hmaerki/experiment_microoctopus/README.md

# HIL (Hardware in the Loop) testinfrastructure

**This repo has to be moved to https://github.com/octoprobe**
