hmaerki/experiment_microoctopus/assessments/assessment_docker_and_udev/README.md

* https://medium.com/swlh/hot-plugging-usb-devices-in-balenaos-5dca4b05ca7e
* https://forums.docker.com/t/udevadm-monitor-in-docker-file/125723
* https://github.com/systemd/systemd/blob/main/rules.d/60-serial.rules
* https://forums.balena.io/t/libudev-cannot-monitor-udev-events-inside-container/363638
