hmaerki/experiment_microoctopus/assessments/assessment_pyudev/README.md

* https://forum.micropython.org/viewtopic.php?t=6063

  * Dave Hylands
    * https://github.com/dhylands/dotfiles/blob/master/bin/find_port.py
    * https://github.com/dhylands/usb-ser-mon.git
    
      * https://github.com/dhylands/usb-ser-mon/blob/master/usb_ser_mon/usb_ser_mon.py

```bash
pip install git+https://github.com/dhylands/usb-ser-mon.git
```

==> Could not make working...

```bash
git clone https://github.com/kjcole/usb-ser-mon
python usb-ser-mon/usb-ser-mon.py -l
USB Serial Device with vendor 'MicroPython' serial '4150325537323318' found @/dev/ttyACM0
USB Serial Device with vendor 'MicroPython' serial 'e661640843495f21' found @/dev/ttyACM1
```

# pyudev

* https://github.com/pyudev
* https://pyudev.readthedocs.io/en/latest/
