hmaerki/experiment_microoctopus/design/design_system.md

# Components

## octoprobe.infa

## octoprobe.infra.usbhub

* Receive USB events
* Know hubs

## octoprobe.tentacle

* Knows RP20240 on the tentacle
* Flash RP2040 (power, picotool, get serial & /dev/usb)
* Given /dev/xy from the tentacle-rp2040
  * Switch relays

## octoprobe.reservation

* Allocations base on tags
