hmaerki/experiment_microoctopus/design/reed_relais.md

https://www.aliexpress.com/item/32788773655.html

https://www.aliexpress.com/item/1005004818274573.html

https://www.aliexpress.com/item/1005003234064658.html

https://www.aliexpress.com/item/1005003025355512.html

https://www.aliexpress.com/item/1005006040700348.html

https://www.aliexpress.com/item/1005004822301240.html

https://jlcpcb.com/partdetail/PanChang-SIP1A05/C10496
  USD 0.68

https://jlcpcb.com/partdetail/CosmoElectronics-D1A050000/C150533
  USD 0.74

Photocouplers
https://jlcpcb.com/partdetail/Toshiba-TLP172GM_TPL_EO/C261926
file:///home/hansm/Downloads/TLP172GM(TPL,E(O.pdf

22 Ohm, COff 30pF

file:///home/hansm/Downloads/TLP172AM(TPL,E.pdf
1 Ohm

Power: FET
IO: photo-MOSFET
