hmaerki/experiment_microoctopus/design/collected_shields.md

# Existing shields

## Raspberry Pi Pico

* Negative: Does not support ribbon cable
* Positive: Stackable Design
* 2x 20 pin

Examples

* https://www.waveshare.com/pico-lora-sx1262-868m.htm
* https://www.waveshare.com/pico-esp8266.htm
* https://www.waveshare.com/pico-10dof-imu.htm
* https://www.waveshare.com/pico-ups-b.htm
* https://www.waveshare.com/pico-environment-sensor.htm
* https://www.waveshare.com/pico-ble.htm
* https://www.waveshare.com/product/pico-ups-a.htm
* https://thepihut.com/products/pico-air-monitoring-expansion

## Raspberry Pi

* 2x20pin

Implemented by

* https://www.play-zone.ch/de/stacking-header-for-raspberry-pi-b-2x20-extra-tall-header-2734.html / https://www.play-zone.ch/de/fileuploader/download/download/?d=1&file=custom%2Fupload%2FFile-1492015621.pdf
* https://www.reichelt.com/ch/de/raspberry-pi-shield-dip-europakarte-stapelbar-rpi-shd-euro-fr4-p243854.html

 * 100 x 160 mm
 * https://cdn-reichelt.de/documents/datenblatt/A300/INFO_RE3020-LF.pdf
 * https://cdn-reichelt.de/documents/datenblatt/A300/EN_RE3020-LF.pdf

Pi stack

* https://www.waveshare.com/stack-hat.htm
  * [Schematic](https://files.waveshare.com/upload/a/ad/Stack_HAT_Schematic.pdf)

Pico vs Pi

* [Pico vs Pi](https://thepihut.com/products/hat-breakout-board-for-raspberry-pi-pico)
  * https://github.com/geeekpi/rpico
  * https://wiki.52pi.com/index.php?title=EP-0139
  * ? schematic not found!

* [Pico vs Pi](https://ch.rs-online.com/web/p/raspberry-pi-hats-und-add-ons/2240176)
  * https://docs.rs-online.com/eddb/A700000007867654.pdf
  * https://www.pi-shop.ch/raspberry-pi-pico-hat-expansion
  * schematic available!

* [Pico vs Pi](https://www.waveshare.com/pico-to-hat.htm)
  * ? schematic not found!

Components

* [Extra Tall Header Kit](https://thepihut.com/products/poe-hat-push-fit-extra-tall-header-kit)
* https://www.pi-shop.ch/geeekpi-40pin-header-kit-box
* https://www.dfrobot.com/product-2358.html
* https://thepihut.com/products/hat-ribbon-cable-for-raspberry-pi-400
* https://thepihut.com/products/pinpal-for-pi-400
* https://thepihut.com/products/40-pin-gpio-ribbon-cable-rainbow-150mm
* https://thepihut.com/products/26-pin-gpio-ribbon-cable-grey-150mm
* https://thepihut.com/products/gpio-ribbon-cable-for-raspberry-pi-model-a-b-pi-2-pi-3
* https://thepihut.com/products/40-pin-extra-tall-header-push-fit-version-no-shroud
* https://thepihut.com/products/breakout-plus
* https://thepihut.com/products/phat-stack
* https://thepihut.com/products/gravity-io-expansion-hat-for-raspberry-pi-4
* https://thepihut.com/products/io-expansion-hat-for-raspberry-pi-3-4-400
* https://thepihut.com/products/giant-butterfly-for-raspberry-pi

Examples

* https://thepihut.com/products/16-universal-inputs-8-layer-stackable-card-for-raspberry-pi
* https://thepihut.com/products/three-40a-240v-relays-rs485-daisy-chainable-hat-for-raspberry-pi
* https://thepihut.com/products/air-monitoring-hat-for-raspberry-pi-pmsa003
* https://thepihut.com/products/gpio-reference-board-model-b-plus-and-a-plus
* https://thepihut.com/products/iqaudio-dac-pro
* https://thepihut.com/products/fan-shim-for-raspberry-pi

# Kicad Pi Hats

* https://github.com/raspberrypi/hats

* https://github.com/devbisme/RPi_Hat_Template
* https://github.com/devbisme/RPi_Hat.pretty
