hmaerki/experiment_microoctopus/design/collected.md

# Espressif

https://github.com/espressif/kicad-libraries

# Raspberry Pico

The Pico minimal design example project has KiCAD symbols/footprints for the RP2040 itself: https://datasheets.raspberrypi.com/rp20 ... -KiCAD.zip

The VGA project has KiCAD symbols/footprints for soldering in a Pico itself:
https://datasheets.raspberrypi.com/rp2040/VGA-KiCAD.zip

https://github.com/ncarandini/KiCad-RP-Pico

# Seeed Pico

https://www.seeedstudio.com/blog/2022/08/19/how-to-use-seeed-studio-xiao-in-your-pcb-design/

https://github.com/Seeed-Studio/OPL_Kicad_Library

# Raspberry Pi

https://github.com/HeadBoffin/RP_Silicon_KiCad
