hmaerki/experiment_microoctopus/design/concept.md

# Gadgets

## Home made gadgets

## Groove Gadgets

## Pico Header Gadgets

# Buses

## Controller Bus

### Control

* I2C
* Power for controller rp2040

Every board has its jumpered unique I2C address.

The controller ochestrates the test using the Control Bus

### Power

Switchable Power. 3V3 and 5V.

### USB

## Gadget Bus

### Power

Switchable Power. 3V3 and 5V.

### IO

* 16x IO
