hmaerki/experiment_microoctopus/branding/octoprobe/octoprobe_logo_v3_inkscape.md

# Create a logo with inkscape

## Rectangle with rounded corners

https://youtu.be/JXrzemHHQG0?si=g5I7pK4Sno1xLvji

## Font

Inkscape: `Manjari`, `Bold`, Font size `18`

## Add a black rectangle and place the text `probe`

Click `probe`, then the rectangle. Menu `Path -> Difference`.

Now the black rectangle has the text `probe` cut out.

## Place text `Octo` and `tentacles`

As Kicad import will ignore the font, the text must be converted into a path: https://www.youtube.com/watch?v=trmR5S1k8Cg
