hmaerki/experiment_microoctopus/assessments/assessment_usbrip/README_unique_id.md

# Serial Numbers

## Summary

Ways to identify, if a RP2 in boot mode and in application mode is the same:

* Powercycle: Both will share the same `udev_devnode`/`udev_sysname`

## Serial Number as from journalctl

SerialNumber Boot mode: E0C9125B0D9B
SerialNumber FS mode: e661640843495f21

```bash
$ lsusb -d 2e8a:0003 -v
 iManufacturer           1 Raspberry Pi
  iProduct                2 RP2 Boot
  iSerial                 3 E0C9125B0D9B
```

==> Seems that all RP2 have the same SerialNumber...
Also XIAO RP2040 has serial E0C9125B0D9B!

## Serial Number as from micropython

```python
>>> import machine
>>> ''.join(f"{i:02x}" for i in machine.unique_id())
'e661640843495f21'
```

## Micropython sources

ports/rp2/modmachine.c

```C
STATIC mp_obj_t mp_machine_unique_id(void) {
    pico_unique_board_id_t id;
    pico_get_unique_board_id(&id);
    return mp_obj_new_bytes(id.id, sizeof(id.id));
}
```

lib/pico-sdk/src/rp2_common/pico_unique_id/unique_id.c

```C
void pico_get_unique_board_id(pico_unique_board_id_t *id_out) {
    *id_out = retrieved_id;
}

void pico_get_unique_board_id_string(char *id_out, uint len) {
    assert(len > 0);
    size_t i;
    // Generate hex one nibble at a time
    for (i = 0; (i < len - 1) && (i < PICO_UNIQUE_BOARD_ID_SIZE_BYTES * 2); i++) {
        int nibble = (retrieved_id.id[i/2] >> (4 - 4 * (i&1))) & 0xf;
        id_out[i] = (char)(nibble < 10 ? nibble + '0' : nibble + 'A' - 10);
    }
    id_out[i] = 0;
}
```

lib/pico-sdk/src/rp2_common/pico_unique_id/include/pico/unique_id.h

```C
/** \file pico/unique_id.h
 *  \defgroup pico_unique_id pico_unique_id
 *
 * Unique device ID access API
 *
 * RP2040 does not have an on-board unique identifier (all instances of RP2040
 * silicon are identical and have no persistent state). However, RP2040 boots
 * from serial NOR flash devices which have a 64-bit unique ID as a standard
 * feature, and there is a 1:1 association between RP2040 and flash, so this
 * is suitable for use as a unique identifier for an RP2040-based board.
 *
 * This library injects a call to the flash_get_unique_id function from the
 * hardware_flash library, to run before main, and stores the result in a
 * static location which can safely be accessed at any time via
 * pico_get_unique_id().
 *
 * This avoids some pitfalls of the hardware_flash API, which requires any
 * flash-resident interrupt routines to be disabled when called into.
 */

#define PICO_UNIQUE_BOARD_ID_SIZE_BYTES 8

/**
 * \brief Unique board identifier
 * \ingroup pico_unique_id
 *
 * This struct is suitable for holding the unique identifier of a NOR flash
 * device on an RP2040-based board. It contains an array of
 * PICO_UNIQUE_BOARD_ID_SIZE_BYTES identifier bytes.
 */
typedef struct {
	uint8_t id[PICO_UNIQUE_BOARD_ID_SIZE_BYTES];
} pico_unique_board_id_t;

/*! \brief Get unique ID
 *  \ingroup pico_unique_id
 *
 * Get the unique 64-bit device identifier which was retrieved from the
 * external NOR flash device at boot.
 *
 * On PICO_NO_FLASH builds the unique identifier is set to all 0xEE.
 *
 * \param id_out a pointer to a pico_unique_board_id_t struct, to which the identifier will be written
 */
void pico_get_unique_board_id(pico_unique_board_id_t *id_out);

/*! \brief Get unique ID in string format
 *  \ingroup pico_unique_id
 *
 * Get the unique 64-bit device identifier which was retrieved from the
 * external NOR flash device at boot, formatted as an ASCII hex string.
 * Will always 0-terminate.
 *
 * On PICO_NO_FLASH builds the unique identifier is set to all 0xEE.
 *
 * \param id_out a pointer to a char buffer of size len, to which the identifier will be written
 * \param len the size of id_out. For full serial, len >= 2 * PICO_UNIQUE_BOARD_ID_SIZE_BYTES + 1
 */
void pico_get_unique_board_id_string(char *id_out, uint len);
```
