hmaerki/experiment_microoctopus/prototypes/prototype_uhubctl-moved-to-pyusbctl/README_hans.md

# Tested Hubs by Hans

## Somehow working

* Visible with `uhubctl`
* Does not power down the RP20240

https://www.digitec.ch/de/s1/product/aten-usb-30-sharing-switch-2-port-switch-box-6299901

https://de.aliexpress.com/item/4001157928019.html

## Somehow working

* Visible with `uhubctl --force`
* Does not power down the RP20240

https://github.com/hmaerki/usb_switches/tree/master/it-well_IT-102AU_USB2
