hmaerki/experiment_microoctopus/branding/images/android_one.png

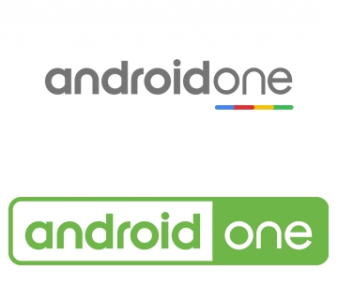
branding/images/android_one.png
