hmaerki/experiment_microoctopus/branding/images/microptyhon_1750_540.png

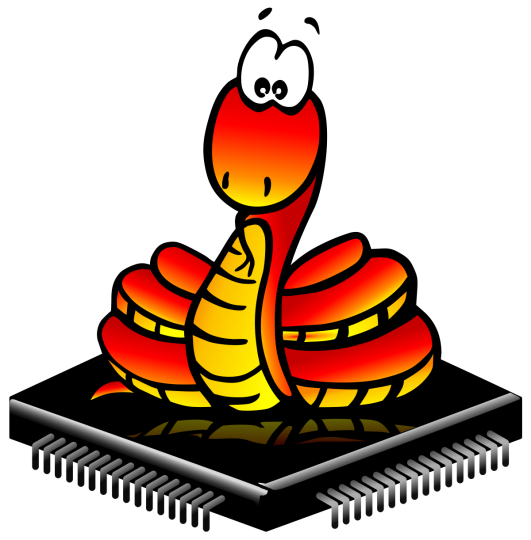
branding/images/microptyhon_1750_540.png
