hmaerki/experiment_microoctopus/branding/images/uOctopus-pytest.png

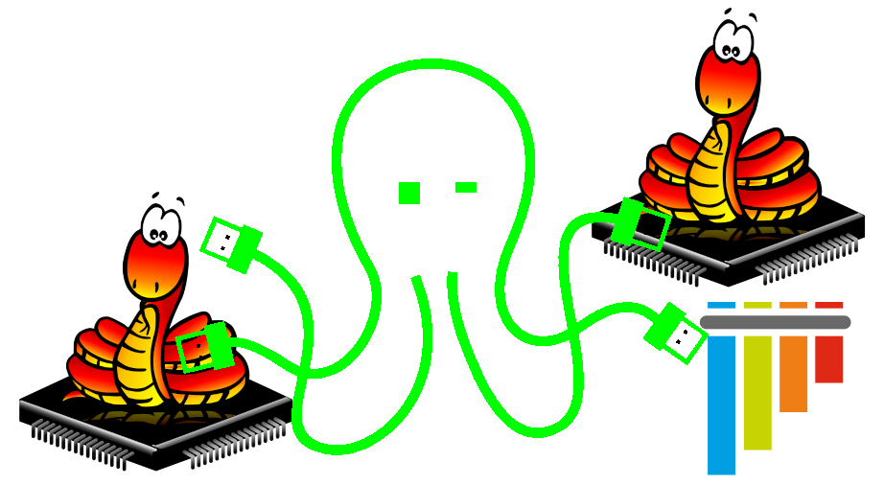
branding/images/uOctopus-pytest.png
