hmaerki/experiment_microoctopus/branding/images/uOctopus.png

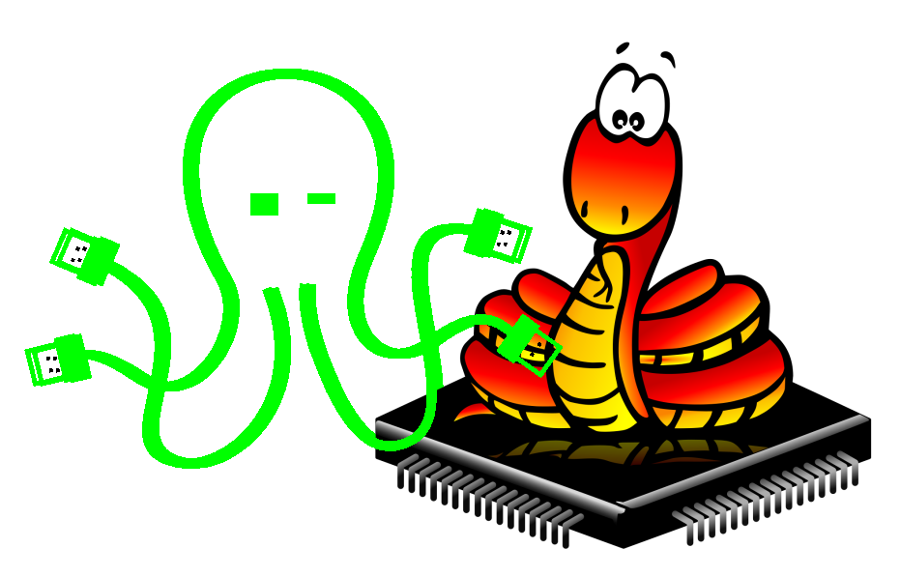
branding/images/uOctopus.png
