hmaerki/experiment_microoctopus/design/component_usb_connector_dut_v2.md

Search in https://jlcpcb.com/parts for `usb 2.0 4P Female  plugin side`

https://jlcpcb.com/partdetail/ShouHan-AF_14_0_CCT/C456020
  USD 0.11
  Stock 2480
  Manufacturer SHOU HAN

  Negative: Only 2 supporting sockets

https://jlcpcb.com/partdetail/ShouHan-AF_90_WJDG/C456018
  USD 0.037
  Stock 34k
  Manufacturer SHOU HAN

  Negative: right angle consumes more space

https://jlcpcb.com/partdetail/Xunpu-USB_226BRW/C720524
  USD 0.1
  Stock 10k
  Manufacturer XUNPU
  MFR Part USB-226-BRW

https://jlcpcb.com/partdetail/Xunpu-USB_226BRW/C720523
  USD 0.12
  Stock 1k
  Manufacturer XUNPU
  MFR Part USB-226-BRY

XUNPU
  https://en.xunpu.com.cn/index.php?s=product&c=search&chatouleibie=1&czfs=3&fsjb=2&catid=25&usbcplx=2

Kicad Footprints

* USB_A_Wuerth_614004134726_Horizontal  https://www.we-online.com/catalog/datasheet/614004134726.pdf
