hmaerki/experiment_microoctopus/design/component_usb_hub.md

# HSB Hubs

* 32 port, USB 2.0
https://www.aliexpress.com/item/1005005196093121.html
CHF 109
Brand: sipolar

* 32 port, USB 2.0
https://www.aliexpress.com/item/1005005196121014.html
CHF 89
Brand: sipolar

* 16 port, USB 3.0
https://www.aliexpress.com/item/1005006460455390.html
CHF 66
Brand: IDSONIX

* 60 ports, Charger only
https://www.aliexpress.com/item/1005004520023365.html
CHF52
