hmaerki/experiment_microoctopus/design/component_sockets.md

## RPI Pin Sockets

https://ae01.alicdn.com/kf/Se11435a0f6f640c8beb57b077fdddc03L.jpg

https://www.aliexpress.com/item/1005002589686953.html
  CHF0.60
https://www.aliexpress.com/item/1776645038.html
  CHF2.58/5
https://www.aliexpress.com/item/1005005747916478.html
  CHF 2.65/10
  simplified socket
https://www.aliexpress.com/item/4000817229179.html
https://www.aliexpress.com/item/1776645038.html
  CHF 2.58/5
https://www.aliexpress.com/item/1005006043503542.html
 CHF 2.37/4
https://www.aliexpress.com/item/1005005804104588.html
  CHF 1.89
