hmaerki/experiment_microoctopus/design/component_usb_connector_dut.md

Search in https://jlcpcb.com/parts for connector usb

* https://jlcpcb.com/partdetail/ShouHan-AF_180_ZJB137/C456015

  Negative: Upright

* https://jlcpcb.com/partdetail/AmphenolIcc-UE27AC54100/C464564

  Amphenol ICC
  Stock: 9517
  $0.47

* https://jlcpcb.com/partdetail/Jst-UBA_4R_D14T_4D_LF_SN/C157903
  Stock: 23401
  $0.58

  Footprint: ~USB_A_Molex_67643_Horizontal
  Footprint: ~USB_A_TE_292303-7_Horizontal

Search in https://jlcpcb.com/parts for usb typea

* https://jlcpcb.com/partdetail/Megastar-ZX_TYPEA_2WCM4/C7419917

  Stock: 283
  $0.07
