hmaerki/experiment_microoctopus/prototypes/prototype_usb_lowspeed/pcb_kicad/00_project_parts/din_rail_pcb_holder-DIN-rail-clip-adjustable.step

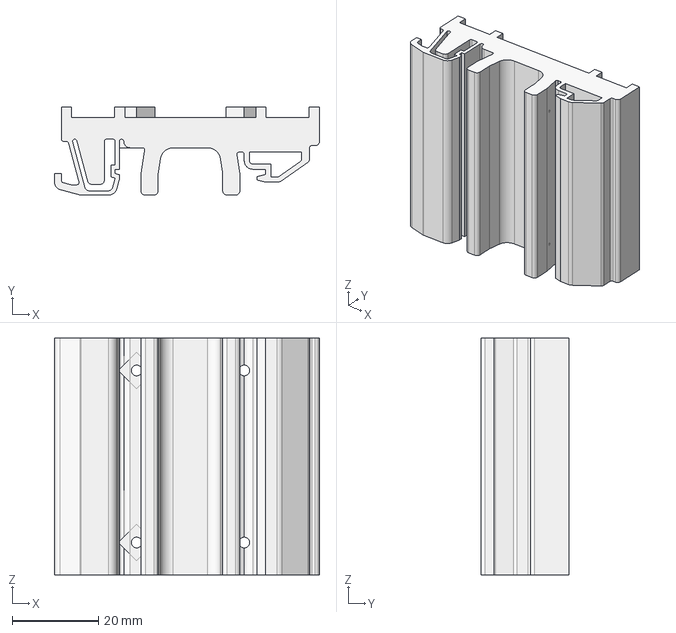
[picture p8: CAD file, 2024-04-01]
prototypes/prototype_usb_lowspeed/pcb_kicad/00_project_parts/din_rail_pcb_holder-DIN-rail-clip-adjustable.step
61.6 x 20.5 x 55.0 mm
