hmaerki/experiment_microoctopus/prototypes/prototype_usb_lowspeed/pcb_kicad/00_project_parts/dip_switch/dip_switch_SPST16/dip_switch_SPST16.step

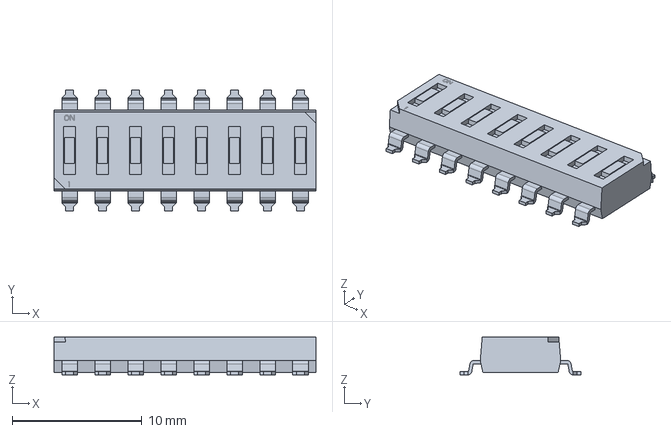
[picture p9: CAD file, 2024-04-01]
prototypes/prototype_usb_lowspeed/pcb_kicad/00_project_parts/dip_switch/dip_switch_SPST16/dip_switch_SPST16.step
20.2 x 9.30 x 2.91 mm
