hmaerki/experiment_microoctopus/prototypes/prototype_usb_lowspeed/pcb_kicad/00_project_parts/weidmueller/1146380000/3D/1146380000.stp

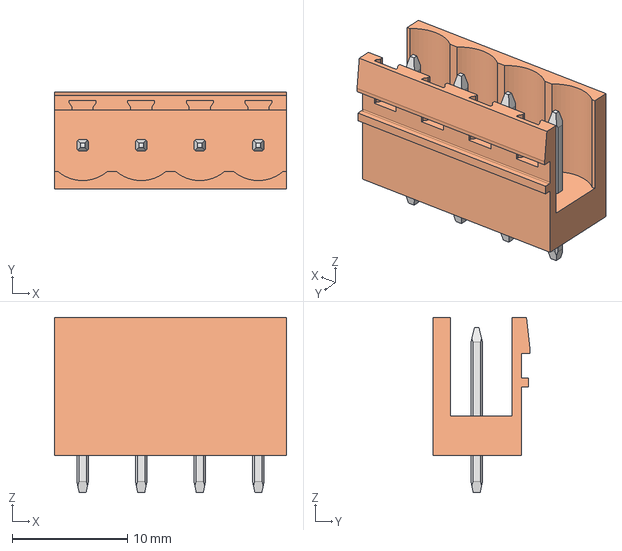
[picture p10: CAD file, 2024-04-01]
prototypes/prototype_usb_lowspeed/pcb_kicad/00_project_parts/weidmueller/1146380000/3D/1146380000.stp
20.1 x 8.43 x 15.2 mm
