hmaerki/experiment_microoctopus/prototypes/prototype_usb_lowspeed/pcb_kicad/00_project_parts/weidmueller/1146900000/3D/1146900000.stp

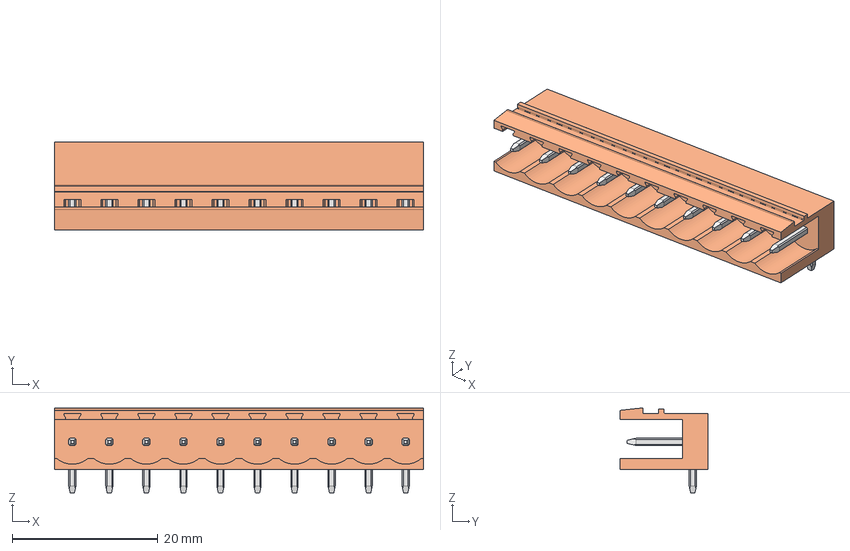
[picture p14: CAD file, 2024-04-01]
prototypes/prototype_usb_lowspeed/pcb_kicad/00_project_parts/weidmueller/1146900000/3D/1146900000.stp
50.6 x 12.0 x 11.6 mm
