hmaerki/experiment_microoctopus/infrastructure_tutorial/tenacle_MCU_seeed_XIAO/README.md

# `TENTACLE_MCU_RASPBERRY_PICO`

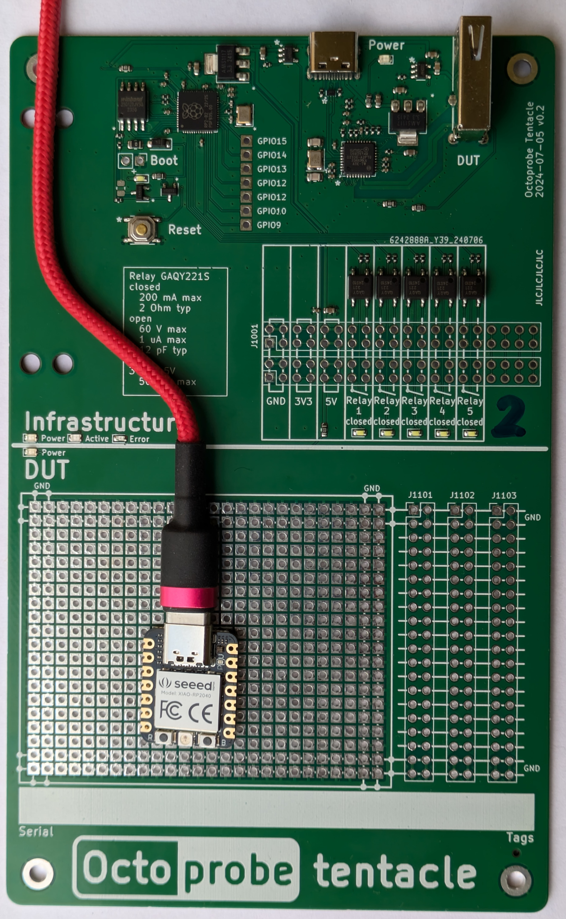
[picture p17: infrastructure_tutorial/tenacle_MCU_seeed_XIAO/tentacle_layout.jpg]
