hmaerki/experiment_microoctopus/design/tests_where_to_start.md

https://github.com/orgs/micropython/discussions/13464#discussioncomment-8175584
  Very trivial tests: https://github.com/mattytrentini/micropython-test-port/tree/master

/home/maerki/gits/micropython/tests/run-tests-exp.py
/home/maerki/gits/micropython/tests/run-multitests.py
