hmaerki/experiment_microoctopus/prototypes/prototype_usb_lowspeed/doc/20240121_empfehlung_hans_high_side_switch.pdf

## Von allen hat JLCPCB an Lager

Empfehlung | LPW5209B5F-21 | 2.1 A Limite | 80 m Ohm

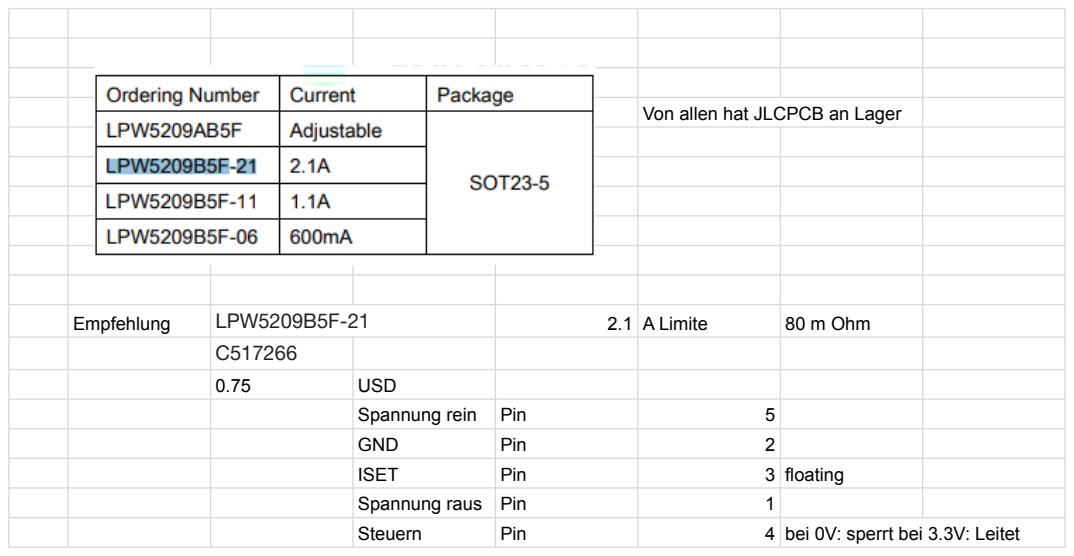
[picture p18: page 1]
USD; Spannung rein; Pin; GND; ISET; 3 floating; Spannung raus Pin; Steuern; 4 bei 0V: sperrt bei 3.3V: Leitet

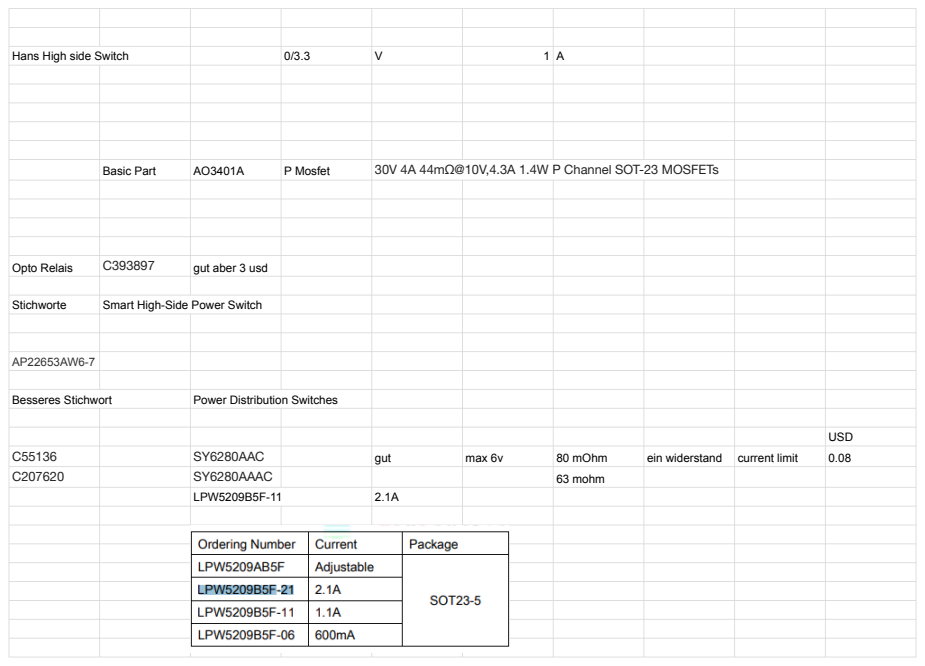
[picture p19: page 2]
Hans High side Switch; Basic Part; P Mosfet; 30V 4A 44mΩ@10V,4.3A 1.4W P Channel SOT-23 MOSFETs; Opto Relais; gut aber 3 usd; Stichworte; Smart High-Side Power Switch; Besseres Stichwort; Power Distribution Switches; USD; SY6280AAC; gut; max 6v; 80 mOhm; ein widerstand; current limit; SY6280AAAC; 63 mohm; LPW5209B5F-11
