hmaerki/experiment_microoctopus/hardware/octoprobe_kicad_v1/pcb_dezentral.kicad_pcb

## KiCad design hardware/octoprobe_kicad_v1/pcb_dezentral.kicad_pcb (2024-05-06)

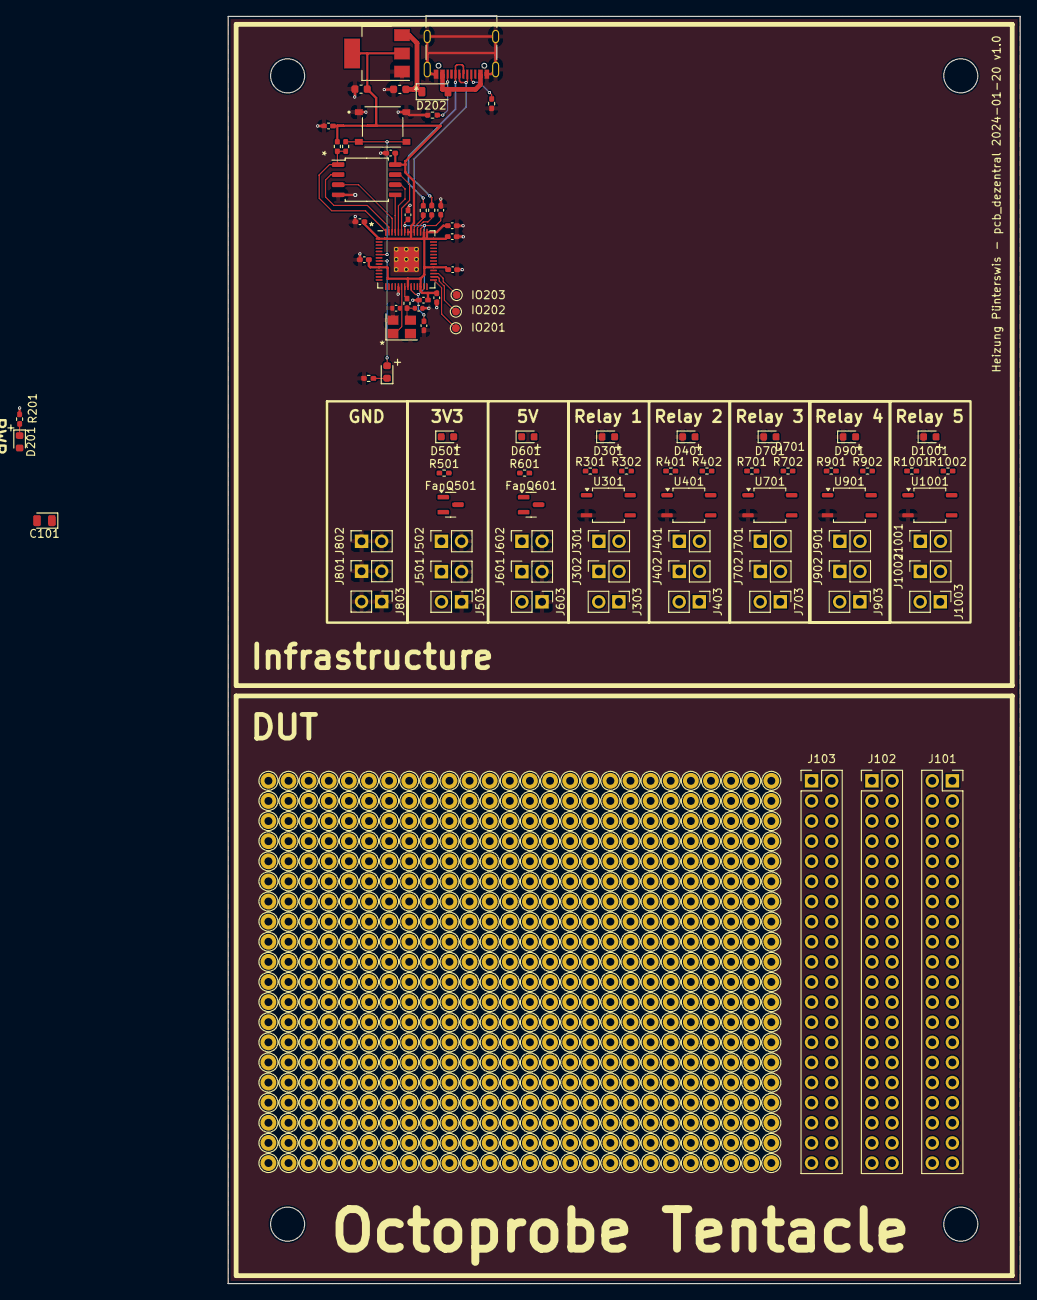
[picture p20: board pcb_dezentral.kicad_pcb from above]

Board: 2 copper layers, 100.0 x 160.0 mm, 100 parts (0 on the bottom side), 58 nets.

Parts:
C101: 100n 50V; D_0805_2012Metric
C201, C202: 10u; C_0603_1608Metric
C203, C204, C207, C208, C209, C212, C213, C214, C215, C216: 100n; C_0402_1005Metric_Pad0.74x0.62mm_HandSolder
C205, C206: 1u; C_0402_1005Metric_Pad0.74x0.62mm_HandSolder
C210, C211: 30p; C_0402_1005Metric
D101, D301, D401, D701, D901, D1001: LED WHITE; LED_0603_1608Metric
D201: LED GREEN; LED_0603_1608Metric
D202: B5819W SL; D_SOD-123
D501, D601: RED; LED_0603_1608Metric
FanQ501, FanQ601: NMOS; SOT-23
IO201, IO202, IO203: TestPoint; TestPoint_Pad_D1.0mm
J101: Conn_01x20; PinSocket_2x20_P2.54mm_Vertical-stackable
J102: Conn_01x20; PinSocket_2x20_P2.54mm_Vertical-mirrored
J103: Conn_01x20; PinSocket_2x20_P2.54mm_Vertical-mirrored-bare
J201: USB_C_Receptacle_USB2.0; USB_C_Receptacle_Palconn_UTC16-G
J301, J302, J401, J402, J501, J502, J601, J602, J701, J702, J801, J802, J901, J902, J1001, J1002: Conn_01x02_Socket; PinSocket_1x02_P2.54mm_Vertical
J303, J403, J503, J603, J703, J803, J903, J1003: Conn_01x02_Pin; PinHeader_1x02_P2.54mm_Vertical
R101, R201, R501, R601: 470R; R_0402_1005Metric_Pad0.72x0.64mm_HandSolder
R202, R203: 27R; R_0402_1005Metric_Pad0.72x0.64mm_HandSolder
R204, R205: 5.1K; R_0402_1005Metric_Pad0.72x0.64mm_HandSolder
R206: 1K; R_0402_1005Metric_Pad0.72x0.64mm_HandSolder
R207, R302, R402, R702, R902, R1002: 10K; R_0402_1005Metric_Pad0.72x0.64mm_HandSolder
R208, R301, R401, R701, R901, R1001: 1k; R_0402_1005Metric_Pad0.72x0.64mm_HandSolder
SW201: SW_MEC_5E; SW_TS-1187A-B-A-B
U201: RP2040; RP2040-QFN-56
U202: AMS1117-3.3; SOT-223-3_TabPin2
U203: W25Q128JVS; SOIC-8_5.23x5.23mm_P1.27mm
U301, U401, U701, U901, U1001: GAQY221S; SOP-4_3.8x4.1mm_P2.54mm
UR101, UR801: GND; opctoprobe_relay
UR301: Relay 1; opctoprobe_relay
UR401: Relay 2; opctoprobe_relay
UR501: 3V3; opctoprobe_relay
UR601: 5V; opctoprobe_relay
UR701: Relay 3; opctoprobe_relay
UR901: Relay 4; opctoprobe_relay
UR1001: Relay 5; opctoprobe_relay
Y201: Crystal_GND24_Small; Crystal_SMD_3225-4Pin_3.2x2.5mm

Connections:
+1V1: C203.1, C204.1, C205.1, U201.23 (DVDD), U201.45 (VREG-VOUT), U201.50 (DVDD)
+3V3: C101.2, C202.1, C206.1, C207.1, C208.1, C209.1, C212.1, C213.1, C214.1, C215.1, C216.1, D201.2 (A), FanQ501.3 (D), R207.1, U201.1 (IOVDD), U201.10 (IOVDD), U201.22 (IOVDD), U201.26 (RUN), U201.33 (IOVDD), U201.42 (IOVDD), U201.43 (ADC-AVDD), U201.44 (VREG-VIN), U201.48 (USB-VDD), U201.49 (IOVDD), U202.2 (VO), U203.8 (VCC)
+5V: C201.1, D202.1 (K), FanQ601.3 (D), U202.3 (VI)
/Relay 4/RELAY_IN: R901.2, R902.1
/Relay 5/RELAY_IN: R1001.2, R1002.1
/cpu/QSPI_SCLK: U201.52 (QSPI-SCLK), U203.6 (CLK)
/cpu/QSPI_SD0: U201.53 (QSPI-SD0), U203.5 (DI(IO0))
/cpu/QSPI_SD1: U201.55 (QSPI-SD1), U203.2 (DO(IO1))
/cpu/QSPI_SD2: U201.54 (QSPI-SD2), U203.3 (IO2)
/cpu/QSPI_SD3: U201.51 (QSPI-SD3), U203.7 (IO3)
/cpu/QSPI_SS: R206.2, R207.2, U201.56 (QSPI-SS-N), U203.1 (~CS)
/cpu/USB_D+: J201.A6 (D+), J201.B6 (D+), R202.1
/cpu/USB_D-: J201.A7 (D-), J201.B7 (D-), R203.1
/cpu/XIN: C210.1, U201.20 (XIN), Y201.1
/cpu/XOUT: R208.1, U201.21 (XOUT)
DUT_3V3: FanQ501.2 (S), J501.1, J502.1, J503.2, R501.2
DUT_5V: FanQ601.2 (S), J601.1, J602.1, J603.2, R601.2
GND: C101.1, C201.2, C202.2, C203.2, C204.2, C205.2, C206.2, C207.2, C208.2, C209.2, C210.2, C211.2, C212.2, C213.2, C214.2, C215.2, C216.2, D301.1 (K), D401.1 (K), D701.1 (K), D901.1 (K), D1001.1 (K), J201.A1 (GND), J201.A12 (GND), J201.B1 (GND), J201.B12 (GND), J201.S1 (SHIELD), J501.2, J502.2, J503.1, J601.2, J602.2, J603.1, J801.1, J801.2, J802.1, J802.2, J803.1, J803.2, R101.1, R201.1, R204.2, R205.2, SW201.1, SW201.2, U201.19 (TESTEN), U201.57 (GND), U202.1 (GND), U203.4 (GND), U301.2, U401.2, U701.2, U901.2, U1001.2, Y201.2, Y201.4
unnamed: C211.1, R208.2, Y201.3
unnamed: D101.1 (K), R101.2
unnamed: D201.1 (K), R201.2
unnamed: D202.2 (A), J201.A4 (VBUS), J201.A9 (VBUS), J201.B4 (VBUS), J201.B9 (VBUS)
unnamed: D301.2 (A), R301.1
unnamed: D401.2 (A), R401.1
unnamed: D501.2 (A), FanQ501.1 (G)
unnamed: D501.1 (K), R501.1
unnamed: D601.2 (A), FanQ601.1 (G)
unnamed: D601.1 (K), R601.1
unnamed: D701.2 (A), R701.1
unnamed: D901.2 (A), R901.1
unnamed: D1001.2 (A), R1001.1
unnamed: J201.A5 (CC1), R204.1
unnamed: J201.B5 (CC2), R205.1
unnamed: J301.1, J302.1, J303.2, U301.4
unnamed: J301.2, J302.2, J303.1, U301.3
unnamed: J401.1, J402.1, J403.2, U401.4
unnamed: J401.2, J402.2, J403.1, U401.3
unnamed: J701.1, J702.1, J703.2, U701.4
unnamed: J701.2, J702.2, J703.1, U701.3
unnamed: J901.1, J902.1, J903.2, U901.4
unnamed: J901.2, J902.2, J903.1, U901.3
unnamed: J1001.1, J1002.1, J1003.2, U1001.4
unnamed: J1001.2, J1002.2, J1003.1, U1001.3
unnamed: R302.2, U301.1
unnamed: R402.2, U401.1
unnamed: R702.2, U701.1
unnamed: R902.2, U901.1
unnamed: R1002.2, U1001.1
unnamed: IO201.1, U201.29 (GPIO18)
unnamed: IO202.1, U201.30 (GPIO19)
unnamed: IO203.1, U201.31 (GPIO20)
unnamed: R203.2, U201.46 (USB-DM)
unnamed: R202.2, U201.47 (USB-DP)
RELAIS_1: R301.2, R302.1, U201.3 (GPIO1)
RELAIS_2: R401.2, R402.1
RELAIS_3: R701.2, R702.1
ZENTRALE_LED: D101.2 (A), U201.8 (GPIO6)
button: R206.1, SW201.3 (K), SW201.4 (A), U201.6 (GPIO4)
