hmaerki/experiment_microoctopus/prototypes/prototype_usb_lowspeed/pcb_kicad/pcb_kicad.kicad_pcb

## KiCad design prototypes/prototype_usb_lowspeed/pcb_kicad/pcb_kicad.kicad_pcb (2024-04-01)

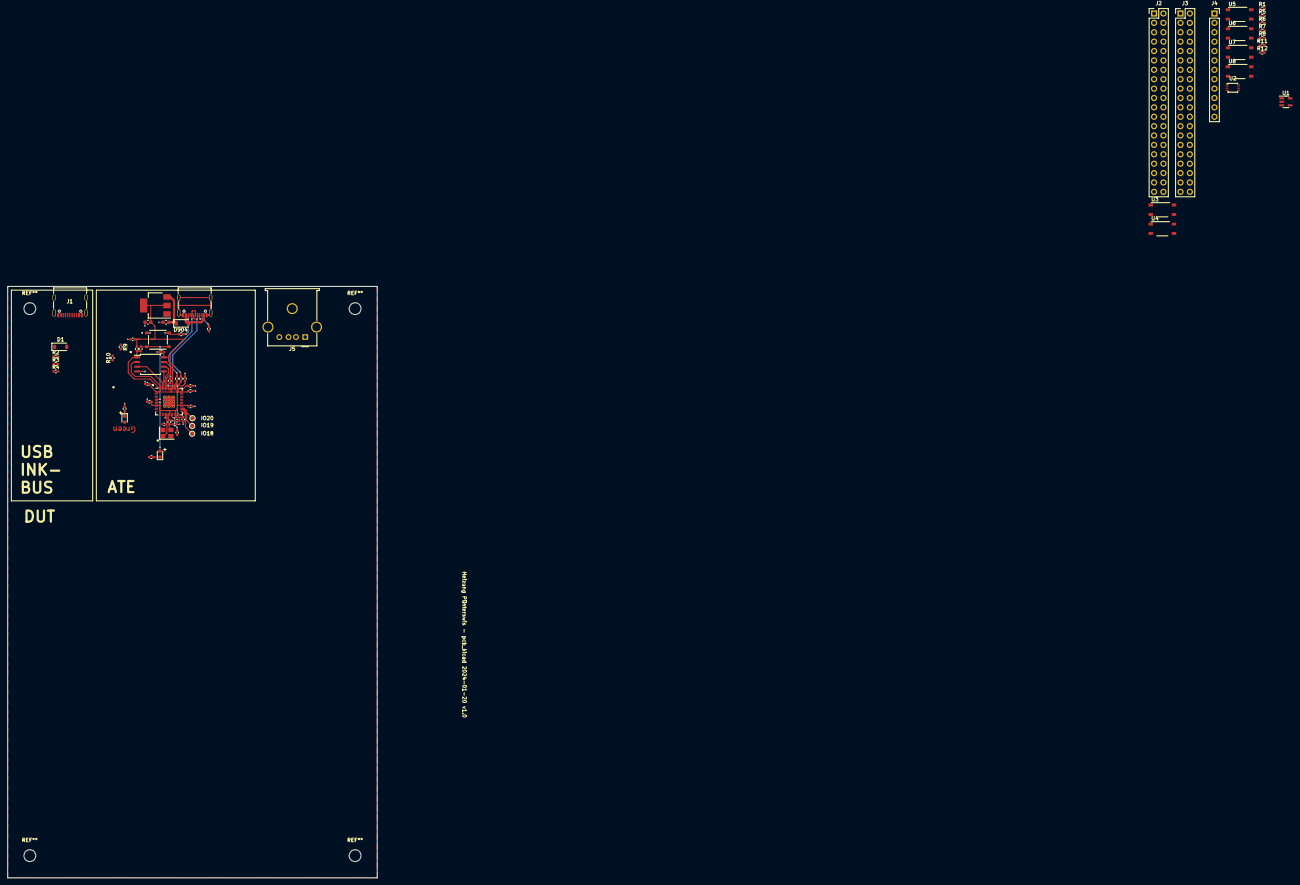
[picture p21: board pcb_kicad.kicad_pcb from above]

Board: 2 copper layers, 100.0 x 160.0 mm, 63 parts (0 on the bottom side), 51 nets.

Parts:
C901, C902: 10u; C_0603_1608Metric
C903, C904, C907, C908, C911, C912, C913, C914, C915, C916: 100n; C_0402_1005Metric_Pad0.74x0.62mm_HandSolder
C905, C906: 1u; C_0402_1005Metric_Pad0.74x0.62mm_HandSolder
C909, C910: 30p; C_0402_1005Metric
D1, D904: B5819W SL; D_SOD-123
D28: LED WHITE; LED_0603_1608Metric
D901: LED GREEN; LED_0603_1608Metric
IO18, IO19, IO20: TestPoint; TestPoint_Pad_D1.0mm
J1, J901: USB_C_Receptacle_USB2.0; USB_C_Receptacle_Palconn_UTC16-G
J2: Conn_01x20; PinSocket_2x20_P2.54mm_Vertical-mirrored
J3: Conn_01x20; PinSocket_2x20_P2.54mm_Vertical-mirrored-bare
J4: Conn_01x12; PinSocket_1x12_P2.54mm_Vertical
J5: USB_A; USB_A_Molex_67643_Horizontal_with_solder_tab
R1: 100; R_0402_1005Metric_Pad0.72x0.64mm_HandSolder
R2, R3, R901, R902: 5.1K; R_0402_1005Metric_Pad0.72x0.64mm_HandSolder
R4: 10; R_0402_1005Metric_Pad0.72x0.64mm_HandSolder
R5, R6, R7, R8, R9, R10, R11, R12: 0; R_0402_1005Metric_Pad0.72x0.64mm_HandSolder
R20, R905: 470R; R_0402_1005Metric_Pad0.72x0.64mm_HandSolder
R903, R904: 27R; R_0402_1005Metric_Pad0.72x0.64mm_HandSolder
R906: 1K; R_0402_1005Metric_Pad0.72x0.64mm_HandSolder
R907: 10K; R_0402_1005Metric_Pad0.72x0.64mm_HandSolder
R908: 1k; R_0402_1005Metric_Pad0.72x0.64mm_HandSolder
SW901: SW_MEC_5E; SW_TS-1187A-B-A-B
U1: LPW5209B5F-21; SOT-23-5
U2: FSUSB31K8X; VSSOP-8_2.4x2.1mm_P0.5mm
U3, U4, U5, U6, U7, U8: TLP172GM; MFSOP6-4_4.4x3.6mm_P1.27mm
U901: RP2040; RP2040-QFN-56
U902: AMS1117-3.3; SOT-223-3_TabPin2
U903: W25Q128JVS; SOIC-8_5.23x5.23mm_P1.27mm
Y901: Crystal_GND24_Small; Crystal_SMD_3225-4Pin_3.2x2.5mm

Connections:
+1V1: C903.1, C904.1, C905.1, U901.23 (DVDD), U901.45 (VREG-VOUT), U901.50 (DVDD)
+3V3: C902.1, C906.1, C907.1, C908.1, C911.1, C912.1, C913.1, C914.1, C915.1, C916.1, D901.2 (A), J4.3, R1.1, R4.2, R907.1, U901.1 (IOVDD), U901.10 (IOVDD), U901.22 (IOVDD), U901.26 (RUN), U901.33 (IOVDD), U901.42 (IOVDD), U901.43 (ADC-AVDD), U901.44 (VREG-VIN), U901.48 (USB-VDD), U901.49 (IOVDD), U902.2 (VO), U903.8 (VCC)
+5V: C901.1, D904.1 (K), J4.4, U902.3 (VI)
/cpu/QSPI_SCLK: U901.52 (QSPI-SCLK), U903.6 (CLK)
/cpu/QSPI_SD0: U901.53 (QSPI-SD0), U903.5 (DI(IO0))
/cpu/QSPI_SD1: U901.55 (QSPI-SD1), U903.2 (DO(IO1))
/cpu/QSPI_SD2: U901.54 (QSPI-SD2), U903.3 (IO2)
/cpu/QSPI_SD3: U901.51 (QSPI-SD3), U903.7 (IO3)
/cpu/QSPI_SS: R906.2, R907.2, U901.56 (QSPI-SS-N), U903.1 (~CS)
/cpu/USB_D+: J901.A6 (D+), J901.B6 (D+), R903.1
/cpu/USB_D-: J901.A7 (D-), J901.B7 (D-), R904.1
/cpu/XIN: C909.1, U901.20 (XIN), Y901.1
/cpu/XOUT: R908.1, U901.21 (XOUT)
DUT_ENABLE_USB2: U5.1, U6.1
DUT_GND: C901.2, C902.2, C903.2, C904.2, C905.2, C906.2, C907.2, C908.2, C909.2, C910.2, C911.2, C912.2, C913.2, C914.2, C915.2, C916.2, J1.A1 (GND), J1.A12 (GND), J1.B1 (GND), J1.B12 (GND), J1.S1 (SHIELD), J2.1, J4.1, J4.2, J5.4 (GND), J5.5 (Shield), J901.A1 (GND), J901.A12 (GND), J901.B1 (GND), J901.B12 (GND), J901.S1 (SHIELD), R2.2, R3.2, R20.1, R901.2, R902.2, R905.1, SW901.1, SW901.2, U1.2 (GND), U2.4 (GND), U5.3, U6.3, U7.3, U8.3, U901.19 (TESTEN), U901.57 (GND), U902.1 (GND), U903.4 (GND), Y901.2, Y901.4
DUT_USB_D+: J4.11, R8.1, R12.1
DUT_USB_D-: J4.12, R7.1, R10.1
IB_USB_DUT_5V: D1.1 (K), J2.5, J5.1 (VBUS), U1.5 (IN)
IB_USB_DUT_D+: J2.11, J5.3 (D+), R6.2, R11.1
IB_USB_DUT_D-: J2.9, J5.2 (D-), R5.2, R9.1
unnamed: C910.1, R908.2, Y901.3
unnamed: D1.2 (A), J1.A4 (VBUS), J1.A9 (VBUS), J1.B4 (VBUS), J1.B9 (VBUS)
unnamed: D28.1 (K), R20.2
unnamed: D901.1 (K), R905.2
unnamed: D904.2 (A), J901.A4 (VBUS), J901.A9 (VBUS), J901.B4 (VBUS), J901.B9 (VBUS)
unnamed: J1.A5 (CC1), R2.1
unnamed: J1.B5 (CC2), R3.1
unnamed: J901.A5 (CC1), R901.1
unnamed: J901.B5 (CC2), R902.1
unnamed: J1.A7 (D-), J1.B7 (D-), R4.1
unnamed: J1.A6 (D+), J1.B6 (D+)
unnamed: R9.2, U5.6
unnamed: R10.2, U5.4
unnamed: R11.2, U6.6
unnamed: R12.2, U6.4
unnamed: R6.1, U2.5 (D+)
unnamed: R5.1, U2.3 (D-)
unnamed: R8.2, U2.6 (HSD+)
unnamed: R7.2, U2.2 (HSD-)
unnamed: R1.2, U2.8 (VCC)
unnamed: IO18.1, U901.29 (GPIO18)
unnamed: IO19.1, U901.30 (GPIO19)
unnamed: IO20.1, U901.31 (GPIO20)
unnamed: R904.2, U901.46 (USB-DM)
unnamed: R903.2, U901.47 (USB-DP)
SW1a (Boot): J4.7, U7.6
SW1b (Boot): J4.8, U7.4
SW2a: J4.9, U8.6
SW2b: J4.10, U8.4
ZENTRALE_LED: D28.2 (A), U901.8 (GPIO6)
button: R906.1, SW901.3 (K), SW901.4 (A), U901.6 (GPIO4)
