hmaerki/experiment_microoctopus/(commit log)

2024-01-12 Initial ideas
    [micropython_testenvironment.kicad_pcb, micropython_testenvironment.kicad_sch]
2024-01-13 Initial ideas 2
    [micropython_testenvironment.kicad_pcb, micropython_testenvironment.kicad_sch]
2024-01-14 RPi_Hat 2
    [micropython_testenvironment.kicad_pcb, micropython_testenvironment.kicad_sch]
2024-01-14 Some documentation
    [micropython_testenvironment.kicad_pcb, micropython_testenvironment.kicad_sch]
2024-01-17 readme to clone kicad parts repos
2024-04-01 New pcb_experiment_usb10
    [1146380000.stp, 1146570000.stp, 1146770000.stp, 1146810000.stp, 1146900000.stp, 1146940000.stp, RPi_Zero_pHat_Template.kicad_pcb, RPi_Zero_pHat_Template.sch]
2024-04-01 microprobe_kicad_v1: Import from heizung_2023
    [RPi_Zero_pHat_Template.kicad_pcb, RPi_Zero_pHat_Template.sch, Raspberry Pi Zero W.kicad_pcb, Raspberry Pi Zero W.sch, Raspberry Pi Zero W.step, TS-1187A-B-A-B.step, TYPE-C-31-M-12--3DModel-STEP-56544.STEP, pcb_dezentral.kicad_pcb]
2024-04-01 microprobe -> octoprobe
    [RPi_Zero_pHat_Template.kicad_pcb, RPi_Zero_pHat_Template.sch, Raspberry Pi Zero W.kicad_pcb, Raspberry Pi Zero W.sch, Raspberry Pi Zero W.step, TS-1187A-B-A-B.step, TYPE-C-31-M-12--3DModel-STEP-56544.STEP, pcb_dezentral.kicad_pcb]
2024-05-06 cleanup pcb
    [pcb_dezentral.kicad_pcb, pcb_dezentral.kicad_sch, pcb_dezentral_cpu.kicad_sch]
2024-05-06 update sheet names
    [pcb_octoprobe.kicad_pcb, pcb_octoprobe.kicad_sch, pcb_octoprobe_cpu.kicad_sch, pcb_octoprobe_gnd.kicad_sch, pcb_octoprobe_opto_relay.kicad_sch, pcb_octoprobe_power.kicad_sch]
2024-05-06 Breakout Board
    [pcb_octoprobe.kicad_pcb, pcb_octoprobe.kicad_sch, pcb_octoprobe_cpu.kicad_sch, pcb_octoprobe_opto_relay.kicad_sch]
2024-06-23 Improve PCB
    [pcb_octoprobe.kicad_pcb, pcb_octoprobe.kicad_sch, pcb_octoprobe_cpu.kicad_sch, pcb_octoprobe_opto_relay.kicad_sch]
2024-06-23 v1 rc1
    [pcb_octoprobe.kicad_pcb, pcb_octoprobe.kicad_sch, pcb_octoprobe_cpu.kicad_sch, pcb_octoprobe_opto_relay.kicad_sch]
2024-06-23 Add 5V 500mA
    [pcb_octoprobe.kicad_pcb]
2024-06-23 Cable Tie
    [pcb_octoprobe.kicad_pcb, pcb_octoprobe.kicad_sch]
2024-06-23 PCB octoprobe tentacle v1.0
    [bom.csv, designators.csv, pcb_octoprobe.kicad_pcb, pcb_octoprobe.kicad_sch, pcb_octoprobe_cpu.kicad_sch, pcb_octoprobe_opto_relay.kicad_sch, positions.csv]
2024-07-13 tentacle v0.2 ordered at JLCPCB
    [RPi_Zero_pHat_Template.kicad_pcb, RPi_Zero_pHat_Template.sch, Raspberry Pi Zero W.kicad_pcb, Raspberry Pi Zero W.sch, Raspberry Pi Zero W.step, TS-1187A-B-A-B.step, TYPE-C-31-M-12--3DModel-STEP-56544.STEP, USB-226-BRW.stp]
2024-07-16 Cleanup images
    [mcu_raspberry_rp2.kicad_sch, tenacle_MCU_raspberry_pico.kicad_sch]
2024-08-04 Connect pyboard/pico to ground
    [mcu_pyboard.kicad_sch, mcu_raspberry_rp2.kicad_sch, tenacle_MCU_grobotics_pyboard.kicad_sch, tenacle_MCU_raspberry_pico.kicad_sch]
2024-08-05 pytest for infrastructure_tutorial
    [tenacle_MCU_raspberry_pico.kicad_sch, tentacle_daq_saleae.kicad_sch]
2024-08-05 PCB: Version number
    [pcb_octoprobe.kicad_pcb, pcb_octoprobe.kicad_sch, pcb_octoprobe_cpu.kicad_sch, pcb_octoprobe_opto_relay.kicad_sch, pcb_octoprobe_prototype_area.kicad_sch, pcb_octoprobe_relay_breakout.kicad_sch, pcb_octoprobe_usbhubchip.kicad_sch, pcb_octoprobe_usbpowerswitch.kicad_sch]
2024-08-05 PCB: Move RP2
    [pcb_octoprobe.kicad_pcb]
2024-08-05 PCB: Octobus
    [pcb_octoprobe.kicad_pcb, pcb_octoprobe.kicad_sch, pcb_octoprobe_cpu.kicad_sch, pcb_octoprobe_opto_relay.kicad_sch, pcb_octoprobe_prototype_area.kicad_sch, pcb_octoprobe_relay_breakout.kicad_sch]
2024-08-05 PCB: Oscillator
    [pcb_octoprobe.kicad_pcb, pcb_octoprobe.kicad_sch, pcb_octoprobe_cpu.kicad_sch, pcb_octoprobe_gnd.kicad_sch, pcb_octoprobe_opto_relay.kicad_sch, pcb_octoprobe_power.kicad_sch, pcb_octoprobe_usbpowerswitch.kicad_sch]
2024-08-05 PCB: Add "Open Hardware"
    [pcb_octoprobe.kicad_pcb, pcb_octoprobe.kicad_sch, pcb_octoprobe_cpu.kicad_sch, pcb_octoprobe_opto_relay.kicad_sch, pcb_octoprobe_prototype_area.kicad_sch, pcb_octoprobe_relay_breakout.kicad_sch, pcb_octoprobe_usbhubchip.kicad_sch, pcb_octoprobe_usbpowerswitch.kicad_sch]
2024-08-05 PCB: Production files ready
    [bom.csv, designators.csv, pcb_octoprobe.kicad_pcb, pcb_octoprobe.kicad_sch, pcb_octoprobe_cpu.kicad_sch, pcb_octoprobe_opto_relay.kicad_sch, pcb_octoprobe_prototype_area.kicad_sch, pcb_octoprobe_relay_breakout.kicad_sch]
2024-08-06 Fixed 'pip install .'
    [device_potpourry.kicad_sch, device_potpourry_daq.kicad_sch, device_potpourry_i2c.kicad_sch, device_potpourry_onewire.kicad_sch, device_potpourry_uart.kicad_sch, infrastructure.kicad_pcb, infrastructure.kicad_sch, mcu_pyboard.kicad_sch]
2024-08-13 New: Tentacle Parts List
    [20240719b_bolzone.stl]
2024-08-18 Deleted directories which have been moved to github/octoprobe
    [20240719b_bolzone.FCStd, 20240719b_bolzone.stl, RPi_Zero_pHat_Template.kicad_pcb, RPi_Zero_pHat_Template.sch, Raspberry Pi Zero W.kicad_pcb, Raspberry Pi Zero W.sch, Raspberry Pi Zero W.step, TS-1187A-B-A-B.step]
