hmaerki/experiment_microoctopus/(notices)

Notices in the files:
hardware/octoprobe_kicad_v1/pcb_dezentral.kicad_pcb:
Released under MIT Open-source License
parts and their libraries:
License: CC BY 4.0
